functionland/BLOX/Electrical/DevKit/documents/documents_md/Architecture.md

# Functionland DevKit Architecture

## Devkit block diagram
The Devkit block diagram is shown in below figure.

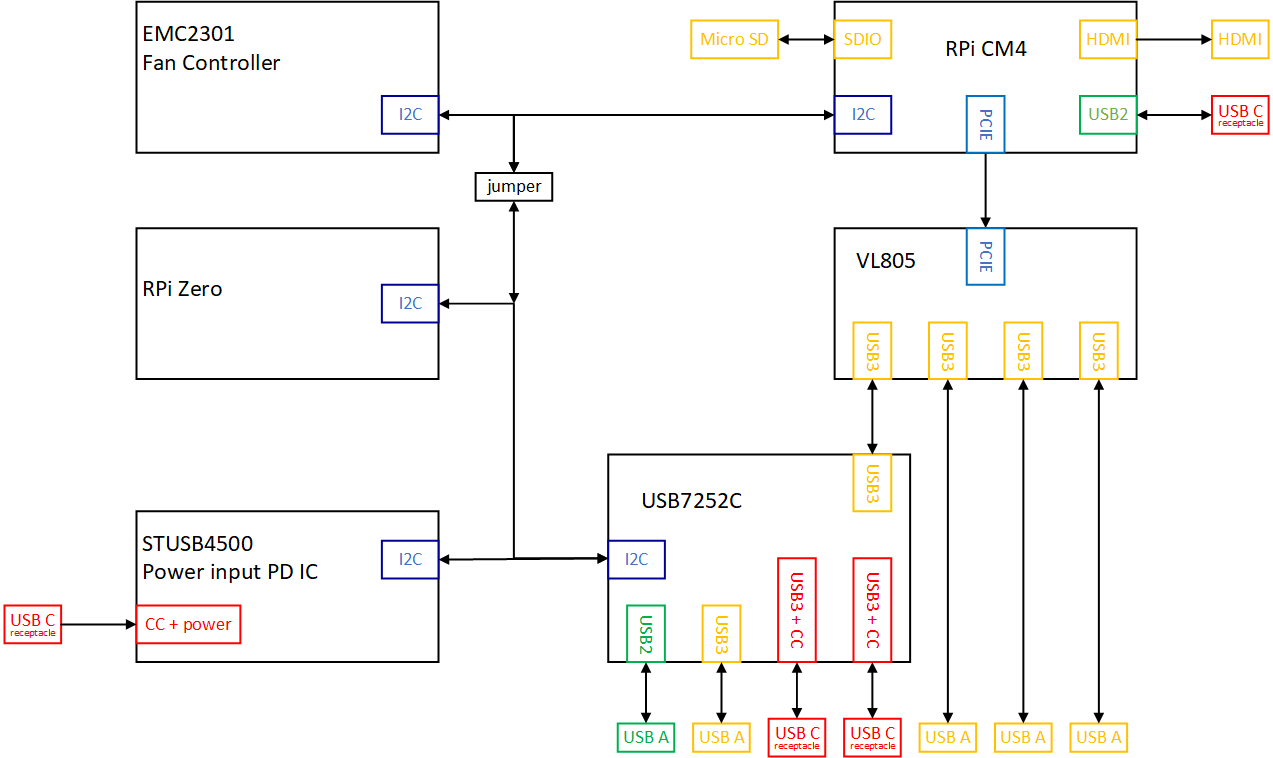
[picture p6: Electrical/DevKit/documents/images/DevKit_block_diagram.png]
DevKit_block_diagram


## Board Features
- RPi CM4 module connector
- RPi Zero module connector
- configuration RPi Zero from USB type-C
- HDMI output port
- Micro SD connector
- Fan connector with PWM controller
- Push button connected to both RPi
- ON-OFF Switch for RPi CM4
- UART TTL connector for both RPi
- Jumpers for enable or disable CM4 features
- 5 USB type A Interfaces
- 2 USB type-C Interfaces
- Power input USB Type-C
- Power input jack
- Power input pin header

&nbsp;

## Board Specifications
### Dimensions
Width: 5.512 in. (14.00 cm)

Length: 5.512 in. (14.00 cm)

Thickness: 0.059 in. (0.15 mm)

**Notes:**

Devkit board documentation (schematics, layout files and board fabrication, 3D model, drawings, etc.) is available on the web at https://github.com/functionland/BLOX/tree/main/Electrical/DevKit/production

&nbsp;

### Environmental
#### Temperature
Operating: 0°C to +45°C

Storage: -25°C to +60°C

#### Humidity
10% to 90% non-condensing

#### Operating Voltage
9-22 VDC
