functionland/BLOX/Electrical/DevKit/documents/Bill of Materials-BAS_DevKITV3(Production).xlsx

ManfactPart | Description | Designator | Comment | LibRef | Quantity | Footprint
 | QR code FxLand 1 | 1 | QR code | ME0023 | 1 | QR_FXLAND_1
CGA2B3X7R1H104K050BB, GCM155R71C104KA55D | 100nF 50V 10% X7R, 100nF 16V 10% X7R | C101, C114, C117, C129, C143, C202, C204, C206, C208, C210, C212, C214, C216, C218, C221, C223, C225, C227, C229, C231, C233, C235, C237, C242, C243, C244, C245, C246, C247, C248, C249, C251, C252, C256, C257, C258, C259, C260, C508, C509, C510, C601, C604, C605, C606, C607, C608, C609, C612, C613, C614, C615, C616, C617, C618, C619, C620, C621, C622, C623, C624, C625, C626, C627, C628, C630, C632, C637 | 100nF | CA0029, CA0010 | 68 | C0402
GRM21BR61C106KE15L, C2012X5R1V106K125AC | 10µF 16V 10% X5R, 10µF 35V 10% X5R | C102, C103, C104, C105, C108, C109, C110, C111, C112, C113, C118, C119, C120, C121, C123, C124, C125, C126, C127, C128, C403, C404 | 10µF | CA0001, CA0005 | 22 | C0805
GRT1555C1H102FA02D | 1nF 50V 1% C0G | C106, C115, C122, C203, C205, C207, C209, C211, C213, C215, C217, C222, C224, C226, C228, C230, C232, C234, C236, C238 | 1nF | CA0031 | 20 | C0402
GCM155R71H122KA37D | 1.2nF 50V 10% X7R | C116 | 1.2nF | CA0030 | 1 | C0402
CC0402GRNPO9BN560 | 56pF 50V 2% C0G | C130 | 56pF | CA0068 | 1 | C0402
GRM155R71H272JA01D | 2.7nF 50V 5% X7R | C131 | 2.7nF | CA0055 | 1 | C0402
C0805C104M5RAC | 100nF 50V 20% X7R | C132, C154, C157 | 100nF | CA0023 | 3 | C0805
GRM188R61C106MAALD | 10µF 16V 20% X5R | C133, C134, C139, C140, C501, C502, C506, C511, C602, C610 | 10µF | CA0008 | 10 | C0603
CGA3E3X5R1V334K080AB | 330nF 35V 10% X5R | C135 | 330nF | CA0004 | 1 | C0603
860010573007 | 100µF 35V 20% 231mA | C136, C155, C156 | 100µF | CA0050 | 3 | RL_6.3_2.5_11
C1608X5R1C475K080AC | 4.7µF 16V 10% X5R | C137, C201, C220 | 4.7µF | CA0002 | 3 | C0603
GCM155R71H392KA37D | 3.9nF 50V 10% X7R | C138 | 3.9nF | CA0066 | 1 | C0402
C1005C0G1H330J050BA | 33pF 50V 5% C0G | C141 | 33pF | CA0067 | 1 | C0402
C0402C681K5RAC | 680pF 50V 10% X7R | C142 | 680pF | CA0065 | 1 | C0402
C1608X5R1C105K080AA | 1µF 16V 10% X5R | C144, C145, C405, C406, C507, C512, C603, C611 | 1µF | CA0003 | 8 | C0603
GRM32ER71J106KA12 | 10µF 63V 10% X7R | C151, C152, C153 | 10µF | CA0024 | 3 | C1210
EMK325ABJ476MM8P | 47µF 16V 20% X5R | C219, C239, C240, C241, C250, C253, C254, C255, C301, C302, C505, C633, C634, C635, C636, C638, C639, C640, C641, C701, C702, C703 | 47µF | CA0007 | 22 | C1210
VJ0402A120FXJCW1BC | 12pF 16V 1% C0G | C261, C262, C629, C631 | 12pF | CA0059 | 4 | C0402
860010675016 | 150µF 50V 20% 363mA | C303, C304 | 150µF | CA0043 | 2 | RL_10_5_12.5
16SVPG330MX | 330µF 16V 20% 16mΩ 4100mA | C401, C402, C503 | 330µF | CA0012 | 3 | EC_E7
16SVPG100M | 100µF 16V 20% 15mΩ 4000mA | C504 | 100µF | CA0011 | 1 | EC_B6
USB4056-03-A | USB C connector Receptacle Horizontal | CO101, CO301, CO302, CO502 | USB4056 | CO0030 | 4 | USB4056-03-A
USB1135-15-9-L-B | USB3.0 Type A receptacle Horizontal | CO303, CO701, CO702, CO703 | USB1135 | CO0041 | 4 | USB1135-15-9-L-B
USB1130-15-A | USB2.0 Type A receptacle Horizontal | CO304 | USB1130 | CO0040 | 1 | USB1130-15-A
693071030811 | µSD-Card holder | CO501 | µSD-Card | CO0027 | 1 | 693071030811
10029449 | HDMI | CO503 | HDMI | CO0007 | 1 | HDMI
ESDA25W | TRANSIL array for data protection | D102 | TVS | DI0009 | 1 | SOT-323
KP-2012CGCK | Led Green | D103, D104, D105, D106, D107, D108, D501, D502, D504, D505 | Led Green | DI0001 | 10 | Led0805
BAS16_R1_00001 | Diodes - General Purpose, Power, Switching 100Vll Signal Switching Diodes 2A | D201, D601 | BAS16 | DI0010 | 2 | SOT-23
TPD2EUSB30DRTR | USB 2 TVS Diode | D301, D302, D303, D304, D503, D702, D704, D706 | TVS | DI0002 | 8 | SOT-3
PUSB3FA2Z | USB 3 TVS Diode | D305, D306, D307, D308, D309, D701, D703, D705 | TVS | DI0007 | 8 | SOT-1176-1
 | Fiducial Round 1mm | Fid1, Fid3, Fid6, Fid8 | Fiducial | ME0011 | 4 | FidR_1.0mm
 | Fiducial Sqaure 1mm | Fid2, Fid4, Fid5, Fid7 | Fiducial | ME0012 | 4 | FidS_1.0mm
 | Mounting Hole M4 | H1, H2, H3, H4 | Hole M4 | ME0002 | 4 | HOLE_M4
AP64501SP-13 | 3.8V TO 40V INPUT, 5A LOW IQ SYNCHRONOUS BUCK WITH PROGRAMMABLE SOFT-START TIME | IC101, IC102 | AP64501SP-13 | IC0031 | 2 | SO-8-EP
HL7504FN04, HL7504FN08 | 3MHz 2A Buck Converter 1.05V OUT, 3MHz 2A Buck Converter 1.10V OUT | IC103, IC105 | HL7504 | IC0049, IC0050 | 2 | DFN-6G_2X2
MCP19035-BAABE/MF | Switching Controllers Synchronous Buck PWM Control 600kHz 12ns | IC104 | MCP19035 | IC0055 | 1 | DFN-10G_3X3
STUSB4500QTR | USB Interface IC Standalone USB PD controller for power sinking devices | IC106 | STUSB4500 | IC0057 | 1 | QFN-24G_4X4
UCS2114 | Dual USB Power Switch with Integrated Current Sensor | IC201, IC205, IC603, IC604 | UCS2114 | IC0056 | 4 | VQFN-20_3X3
SST26VF016B-104V/SN | 16 Mbit Serial Quad I/O (SQI) Flash Memory | IC202 | SST26VF016B | IC0059 | 1 | SO-8
USB7252C | 4-Port USB 3.2 Gen 2 Type-C Controller Hub | IC203 | USB7252C | IC0047 | 1 | VQFN-100G_12X12
MC74HC1G02DTT1G | Logic Gates 2-6V Single 2-Input NOR | IC204 | MC74HC1G02 | IC0061 | 1 | TSOP-5
RT9742GGJ5 | RT9742 High side power switch | IC501 | RT9742 | IC0029 | 1 | SOT-23-5
EMC2301-1-ACZL-TR | Board Mount Temperature Sensors Single RPB-Based PWM Fan Speed CNTRL | IC502 | EMC2301 | IC0054 | 1 | MSOP-8_3X3
RT9742SNGV | RT9742SNGV | IC503 | RT9742 | IC0011 | 1 | SOT-23
SN74LVC1G07DBVT | Buffer IC | IC504 | SN74LVC1G07D | IC0009 | 1 | SOT-23-5
AT25SF321B-SSHB-T | 32-Mbit SPI Serial Flash Memory with Dual-I/O and Quad-I/O Support | IC601 | AT25SF321B | IC0053 | 1 | SO-8
VL805-Q6 | VL805 4-Port USB 3.0 Host Controller | IC602 | VL805 | IC0046 | 1 | QFN-68G_8X8
G800MJ302018EU | Header 1x6P SMT Mount | J103, J201 | Header | CO0043 | 2 | 1X6P_2.54MM_SMT
 | SPI Programming connection | J202, J601 | SPI | ME0028 | 2 | SPI_PROG_TYPE1
G800W305018EU | Header 1x3P | J401, J402, J505 | Header | CO0018 | 3 | 1X3P_2.54mm
470531000 | Fan Connector 4pin | J502 | Fan Connector | CO0010 | 1 | 470531000
G800W306018EU | Header 1x2P | J504, J507, J508, J509 | Header | CO0012 | 4 | 1X2P_2.54mm
SRN6045TA-3R3Y | 3.3µH 5A 30% 21mΩ | L101, L102 | 3.3µH 5A | IN0005 | 2 | SRN6045TA
NRS4018T2R2MDGJ | 2.2µH 3A | L103, L105 | 2.2µH 3A | IN0004 | 2 | NRS4018
0630CDMCDDS-1R0MC | 1.5µH 14.4A 20% 7.4mΩ | L104 | 1.5µH 14.4A | IN0017 | 1 | 0630CDMCDDS
 | Logo FxLand 3 | Logo FxLand1 | FxLand | ME0008 | 1 | Logo_FxLand_3
9900002236265 | RPI ZeroW Header 1-40 | MO401 | ZeroW-1 | MO0017 | 1 | RPIZeroW_HeaderPins
9774030151R | RPI ZeroW Mounting Studs | MO402, MO403, MO404, MO405 | ZeroW-M | MO0016 | 4 | CM4-M
RPI Zero W | Outline of ZeroW Heigthened P\lacement | MO406 | ZeroW | MO0022 | 1 | RPIZeroW_Layout_Heightened
DF40HC(3.0)-100DS-0.4V | RPI CM4 Pin 1-100 | MO501 | CM4-1 | MO0012 | 1 | CM4_001-100
DF40HC(3.0)-100DS-0.4V | RPI CM4 Pin 101-200 | MO502 | CM4-2 | MO0013 | 1 | CM4_101-200
9774030151R | RPI CM4 Mounting Studs | MO503, MO504, MO505, MO506 | CM4-M | MO0014 | 4 | CM4-M
RPI CM4 | Outline of CM4 | MO507 | CM4 | MO0011 | 1 | RPICM4_Layout
WR06X1000FTL | 100Ω 1% 100mW | R101, R106, R119 | 100Ω | RS0007 | 3 | R0603
RC0402FR-1312KL | 12KΩ 1% 62.5mW | R102, R216, R501 | 12KΩ | RS0015 | 3 | R0402
ERJ-S02F2002X | 20KΩ 1% 100mW 100PPM | R103, R115 | 20KΩ | RS0034 | 2 | R0402
CRGCQ0402F2K2, MCMR04X222 JTL | 2.2KΩ 1% 62.5mW 100PPM, 2.2KΩ 5% 62.5mW | R104, R505, R506, R511, R512 | 2.2KΩ | RS0035, RS0020 | 5 | R0402
CRCW060369K8FKEB | 69.8KΩ 1% 100mW 100PPM | R107 | 69.8KΩ | RS0041 | 1 | R0603
CRCW040210K5FKEDC | 10.5KΩ 1% 62.5mW 100PPM | R108 | 10.5K | RS0054 | 1 | R0402
RC0603FR-0722K1L | 22.1KΩ 1% 100mW 100PPM | R109, R218 | 22.1KΩ | RS0040 | 2 | R0603
0402WGF1004TCE | 1MΩ 1% 62.5mW 100PPM | R110, R113 | 1MΩ | RS0066 | 2 | R0402
AC0402FR-13100KL | 100KΩ 1% 62.5mW 100PPM | R111, R112, R118, R126, R127, R202, R205, R247, R406, R619 | 100KΩ | RS0036 | 10 | R0402
0402WGF8201TCE | 8.2KΩ 1% 62.5mW 100PPM | R114 | 8.2KΩ | RS0079 | 1 | R0402
CRG0402F750R | 750Ω 1% 62.5mW 100PPM | R116 | 750Ω | RS0078 | 1 | R0402
CRG0402F2K7 | 2.7KΩ 1% 62.5mW 100PPM | R117 | 2.7KΩ | RS0059 | 1 | R0402
MCWR04X2202FTL | 22KΩ 1% 62.5mW 100PPM | R120 | 22KΩ | RS0033 | 1 | R0402
WR06X102 JTL | 1KΩ 5% 100mW | R121, R122, R130 | 1KΩ | RS0008 | 3 | R0603
RC0402JR-131KL | 1KΩ 5% 62.5mW 100PPM | R123, R124 | 1KΩ | RS0037 | 2 | R0402
WR04X1002FTL | 10KΩ 1% 62.5mW | R125, R203, R204, R212, R213, R214, R215, R228, R229, R231, R234, R235, R236, R243, R401, R405, R508, R601, R602, R607, R608, R609, R611, R612, R613, R614, R623, R624 | 10KΩ | RS0011 | 28 | R0402
MCWR06X1500FTL | 150Ω 1% 100mW | R129, R132, R504, R510, R515, R516 | 150Ω | RS0001 | 6 | R0603
RT0603BRE0750RL | 50Ω 0.1% 100mW 50PPM | R131 | 50Ω | RS0080 | 1 | R0603
CRCW040243K0FKEDC | 43KΩ 1% 62.5mW 100PPM | R201, R237 | 43KΩ | RS0076 | 2 | R0402
CRG0402F200K | 200KΩ 1% 62.5mW 100PPM | R206, R209, R210, R219, R220, R221, R222, R223, R224, R225, R226, R230 | 200KΩ | RS0045 | 12 | R0402
0402WGF4992TCE | 49.9KΩ 1% 62.5mW 100PPM | R211, R241 | 49.9KΩ | RS0077 | 2 | R0402
CRCW04025K10FKEDC | 5.1KΩ 1% 62.5mW 100PPM | R217, R502, R509 | 5.1kΩ | RS0038 | 3 | R0402
0402WGF3302TCE | 33KΩ 1% 62.5mW 100PPM | R227, R244 | 33KΩ | RS0075 | 2 | R0402
0402WGJ0000TCE | 0Ω 62.5mW | R232, R233, R239, R242, R248, R249, R250, R251, R519, R615, R616, R621, R625, R626 | 0Ω | RS0074 | 14 | R0402
WR06X4701FTL | 4.7KΩ 1% 100mW | R402, R403, R404 | 4.7KΩ | RS0002 | 3 | R0603
ERJ-2RKF3602X | 36KΩ 1% 62.5mW 100PPM | R513 | 36KΩ | RS0051 | 1 | R0402
WR06X103 JTL | 10KΩ 5% 100mW | R514 | 10KΩ | RS0003 | 1 | R0603
0201WMJ0330TEE | 33Ω 5% 50mW 200PPM | R603, R604 | 33Ω | RS0067 | 2 | R0201
0201WMF499JTEE | 49.9Ω 1% 50mW 200PPM | R605, R606 | 49.9Ω | RS0069 | 2 | R0201
RC0402FR-076K04L | 6.04KΩ 1% 62.5mW | R610 | 6.04KΩ | RS0017 | 1 | R0402
TS02-66-50-BK-160-SCR-D | TACTILE SWITCH SPST | SW201 | TS02 | SW0005 | 1 | TS02
PTS645VK832LFS | TACTILE SWITCH SPST | SW401, SW503 | PTS645 | SW0003 | 2 | PTS645-V
OS102011MS2QN1 | Miniature Slide Switch SPDT | SW504 | OS102011 | SW0001 | 1 | OS10_Series
 | Testpoint 1mm | TP_+1V1, TP_+1V05, TP_+3V3, TP_+5VR, TP_+5VU, TP_CPWR, TP_GND, TP_VIN, TP_VPWR | TP | ME0027 | 9 | TP_1MM
SIRA24DP-T1-GE3 | 25V/2.4mΩ, N-channel Power MOSFET, 35.6A | TR102 | SiRA24DP | TR0012 | 1 | PowerPAK-SO-8_5X6
SIRA12BDP-T1-GE3 | 30V/6mΩ, N-channel Power MOSFET, 22A | TR103 | SiRA12BDP | TR0013 | 1 | PowerPAK-SO-8_5X6
STL8P4LLF6 | 40V/17.5mΩ, P-channel Trench MOSFET, 8A | TR104 | STL8P4LLF6 | TR0010 | 1 | PowerFLAT-3.3x3.3-8
403WF25012IK | 25MHz 8pF 20PPM | X201, X601 | 25MHz | CR0003 | 2 | 403W
