functionland/BLOX/Electrical/DevKit/documents/schematic.PDF

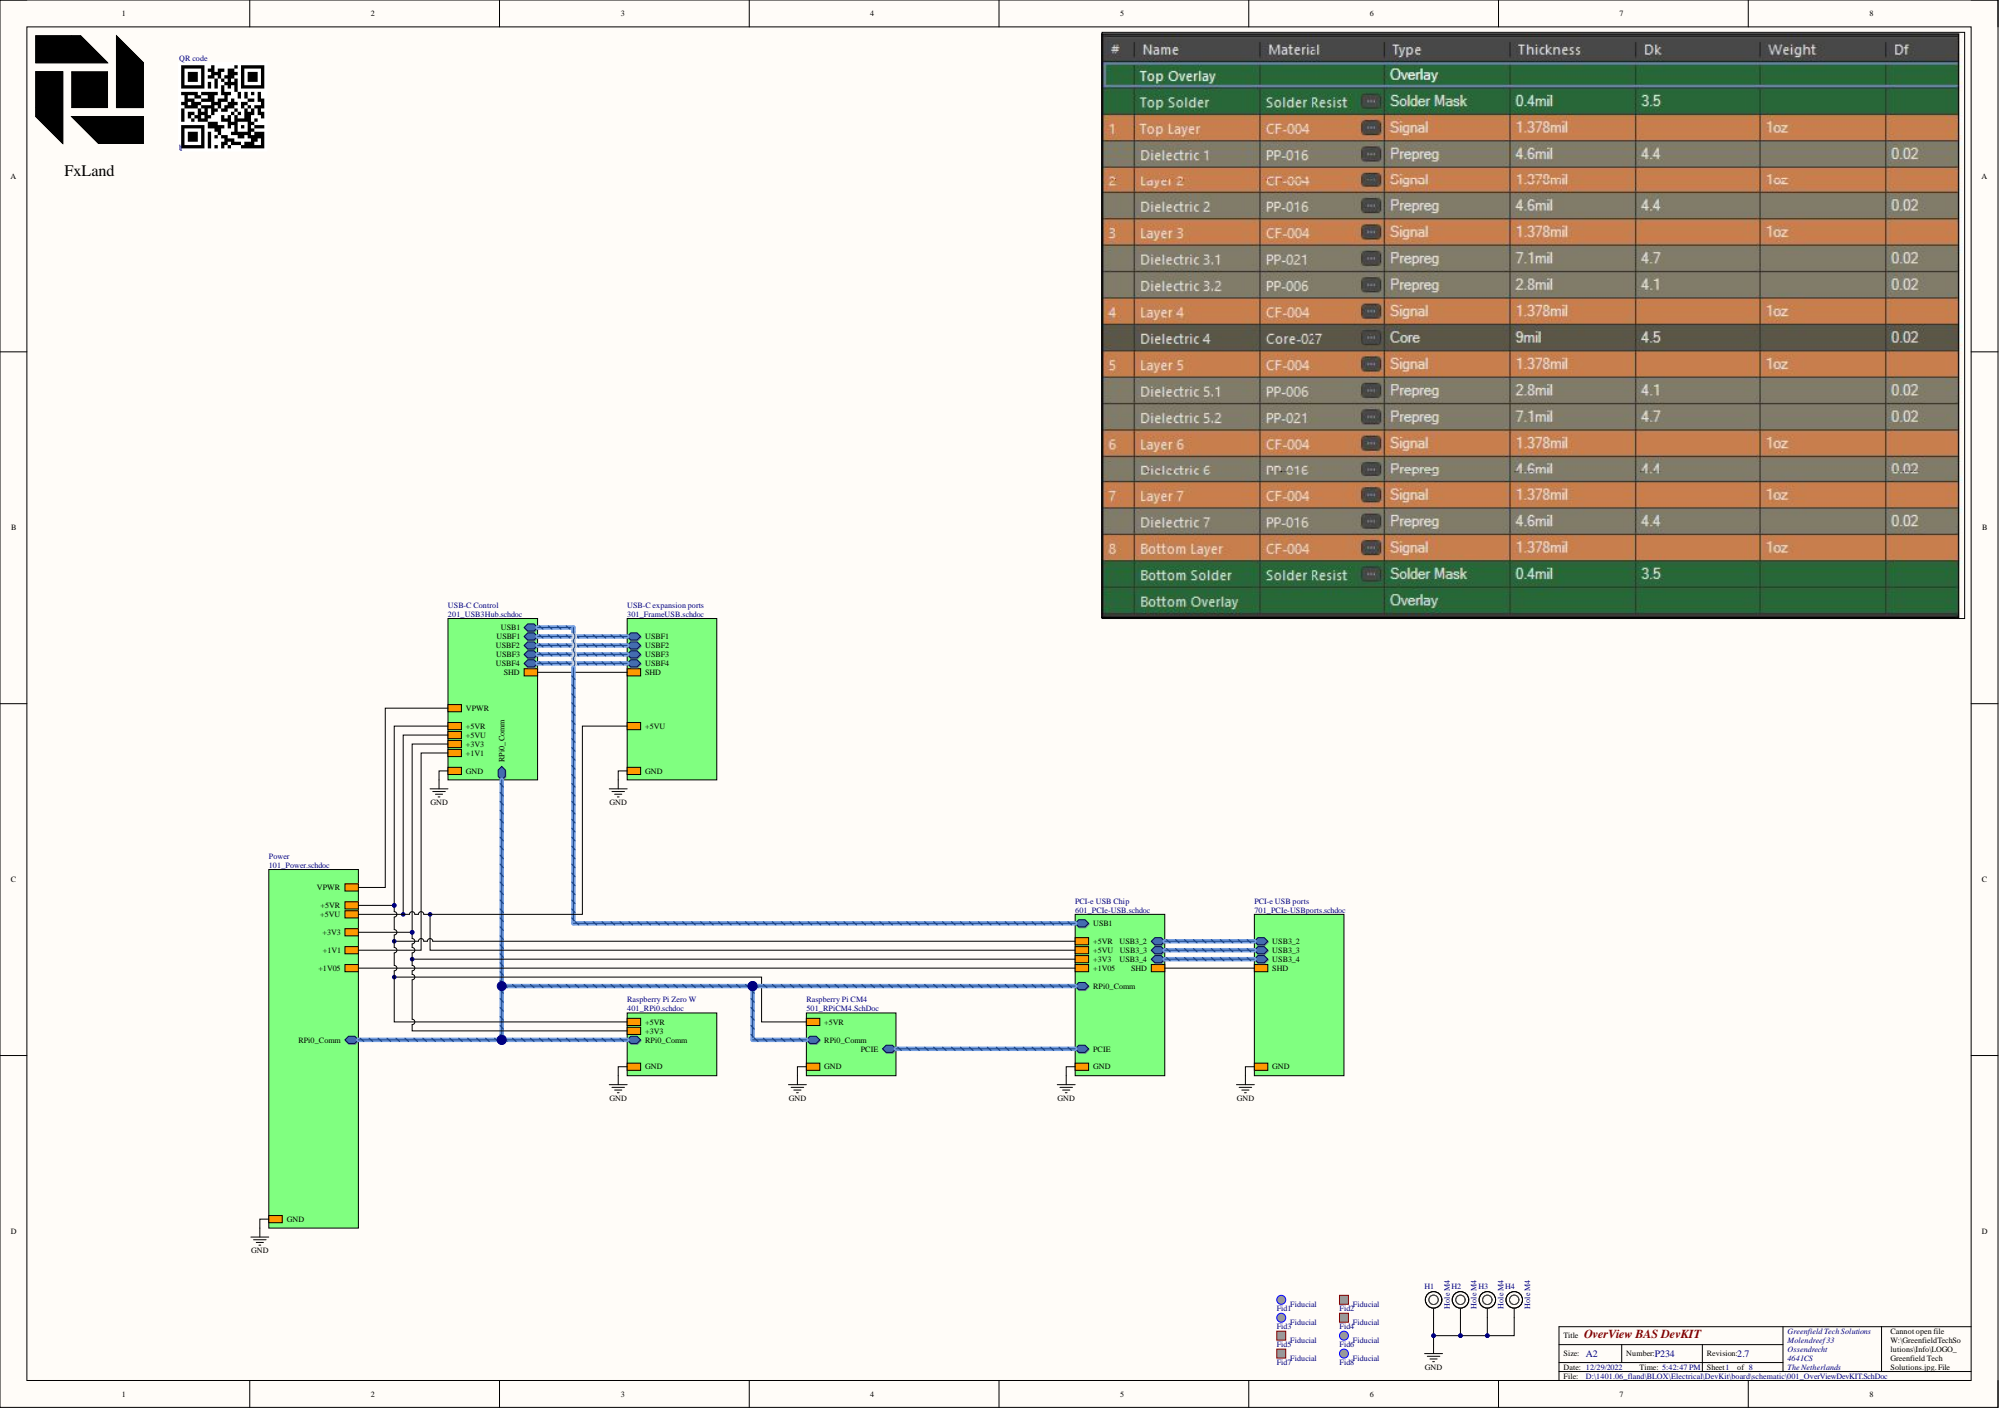
[picture p11: page 1]

D:\1401.06_fland\BLOX\Electrical\DevKit\board\schematic\001_OverViewDevKIT.SchDoc

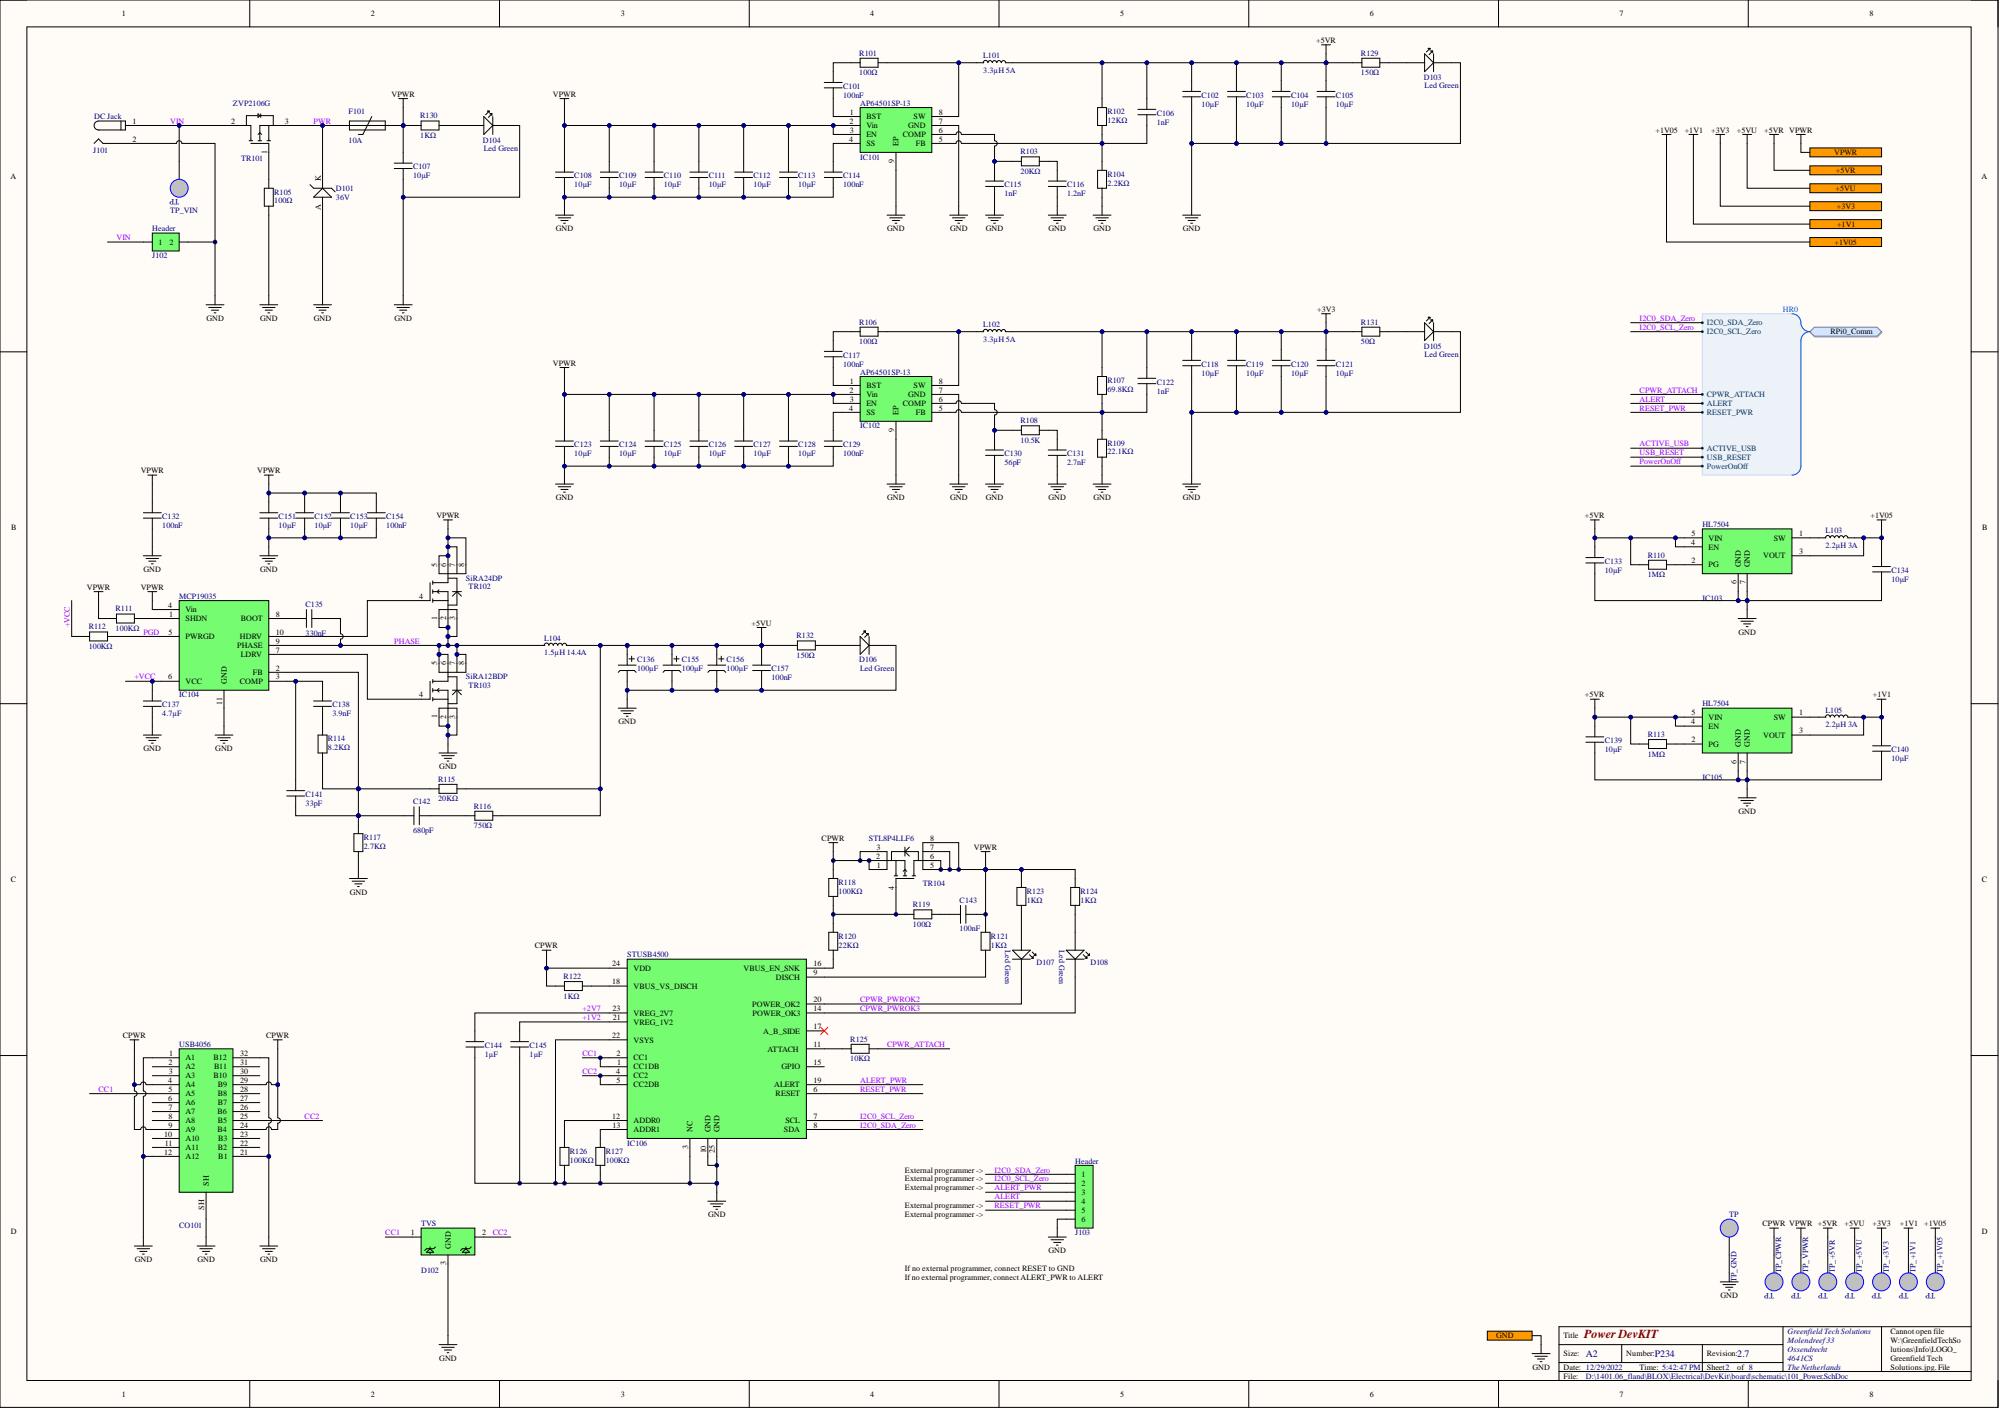
[picture p12: page 2]

PWRGD 5 | 330nF
VCC 6 | | PHASE

If no external programmer, connect RESET to GND
If no external programmer, connect ALERT_PWR to ALERT

D:\1401.06_fland\BLOX\Electrical\DevKit\board\schematic\101_Power.SchDoc

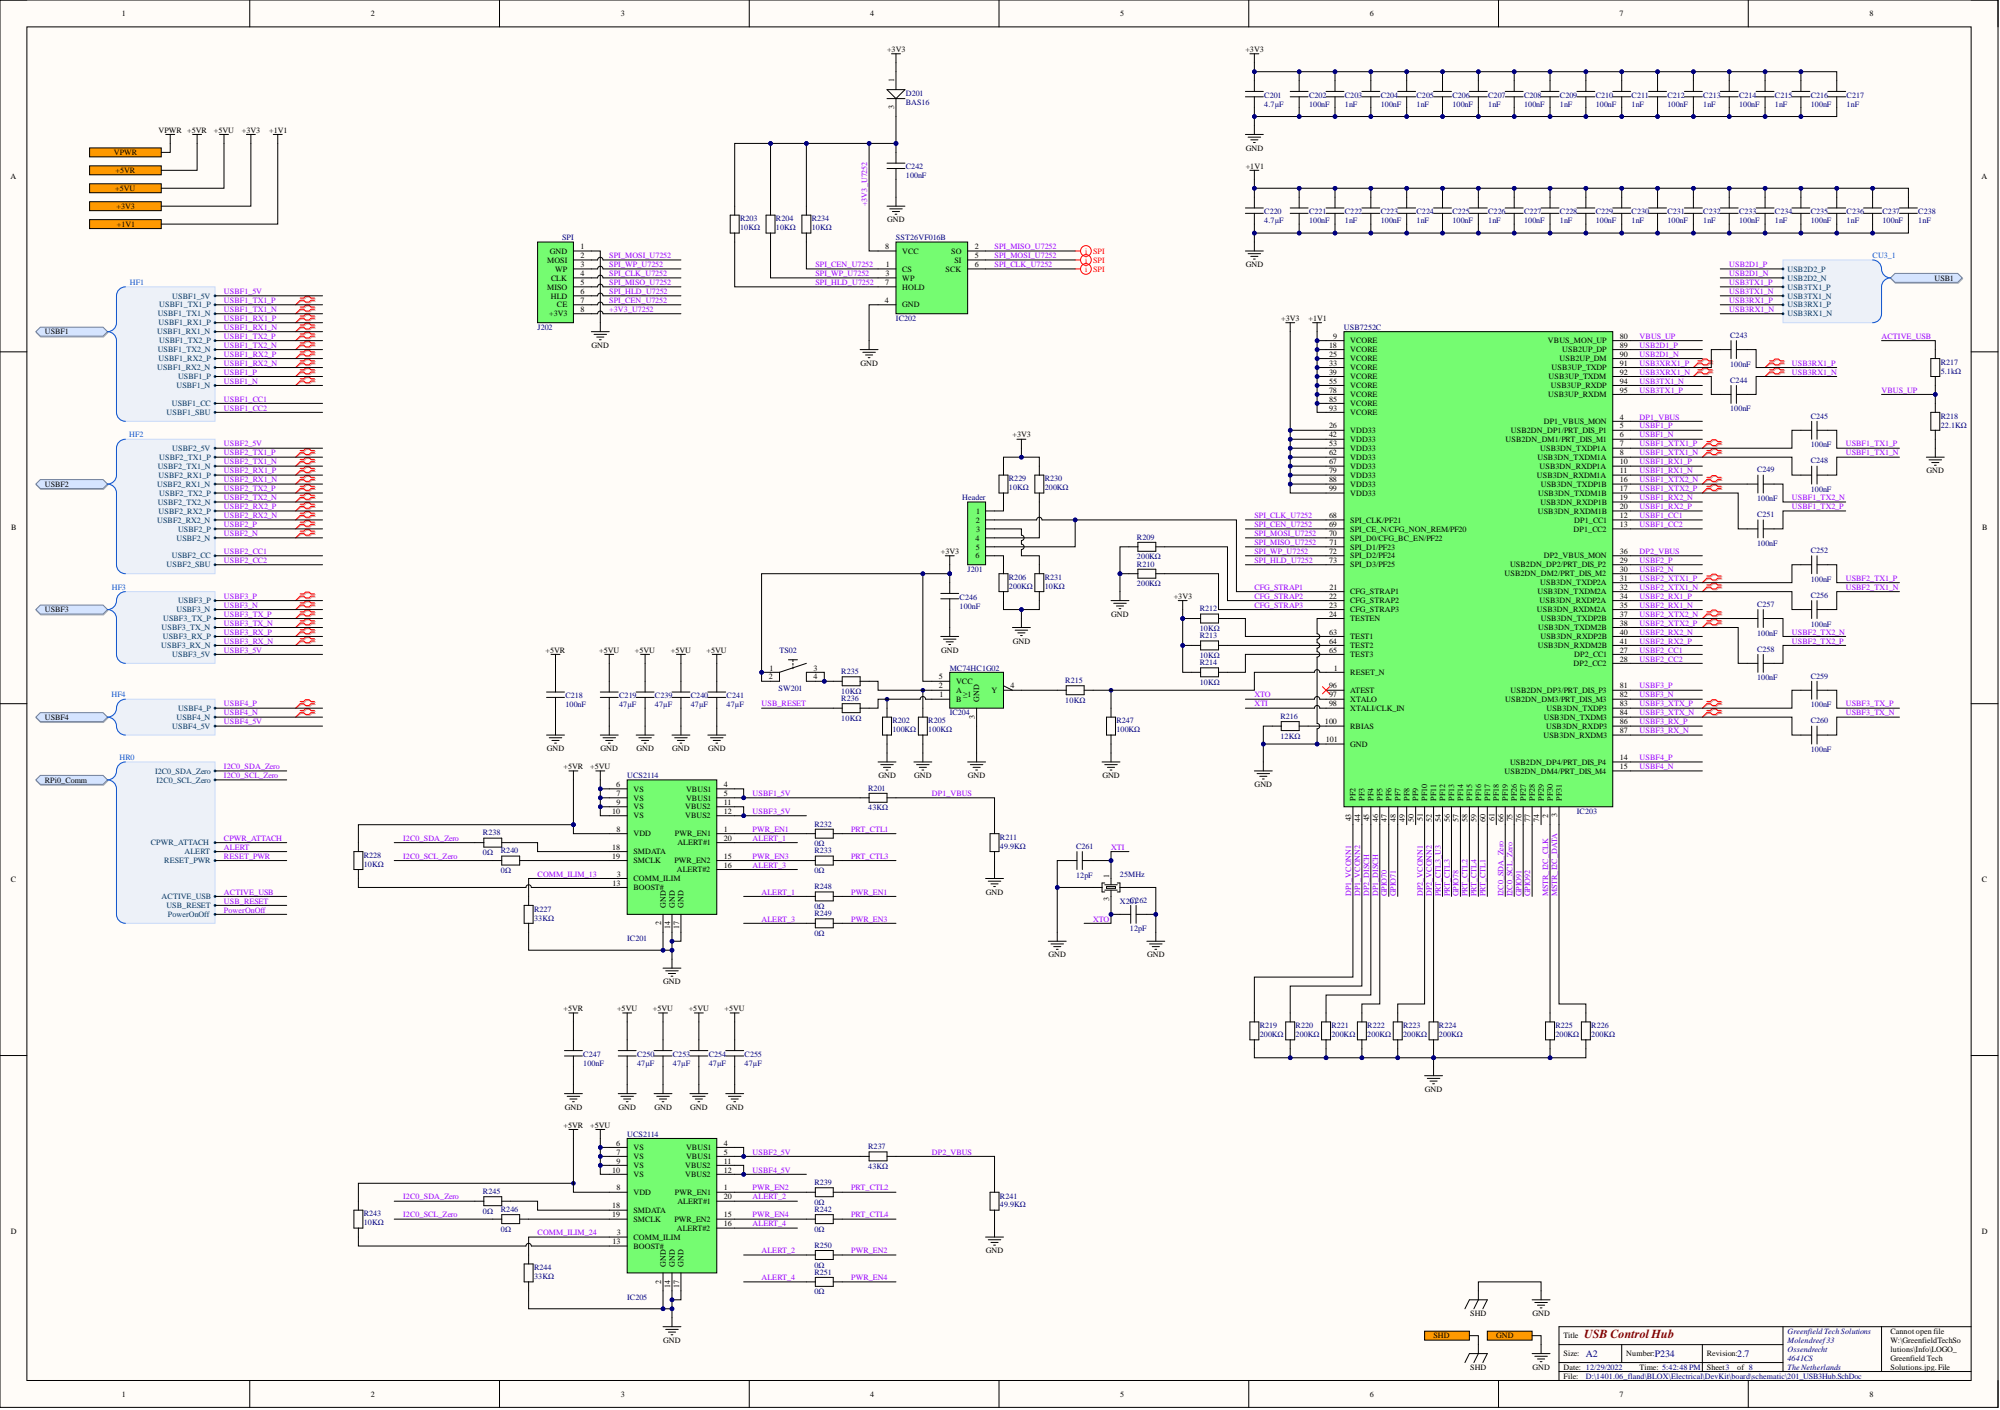
[picture p13: page 3]

VCORE 18 | USB2D1_P
VCORE 25 | | USB2D1_N | USB3RX1_P
VCORE 33 | | USB3XRX1_P
VCORE 39 | USB3XRX1_N USB3RX1_N
VCORE 55 | | USB3TX1_N

VDD33 42 | | USBF1_N | | USBF1_TX1_P
VDD33 53 | | USBF1_XTX1_P
VDD33 62 | USBF1_XTX1_N USBF1_TX1_N
VDD33 67 | | USBF1_RX1_P C249
VDD33 79 | | USBF1_RX1_N
VDD33 88 | USBF1_XTX2_N
VDD33 99 | USBF1_XTX2_P | | 100nF USBF1_TX2_N
SPI_CLK/PF21 68 | USBF1_RX2_N

CFG_STRAP3 | | CFG_STRAP3 23 | | USBF2_RX1_N

TESTEN 24 | USBF2_XTX2_N
TEST1 63 | USBF2_XTX2_P | 100nF USBF2_TX2_N

USBF2_RX2_N

TEST2 64 | | USBF2_RX2_P
TEST3 65 | | USBF2_CC1
RESET_N 1 | | USBF2_CC2

USBF3_RX_P

12KΩ | | GND 101 | USBF3_RX_N

VS 7
VS 9

D:\1401.06_fland\BLOX\Electrical\DevKit\board\schematic\201_USB3Hub.SchDoc

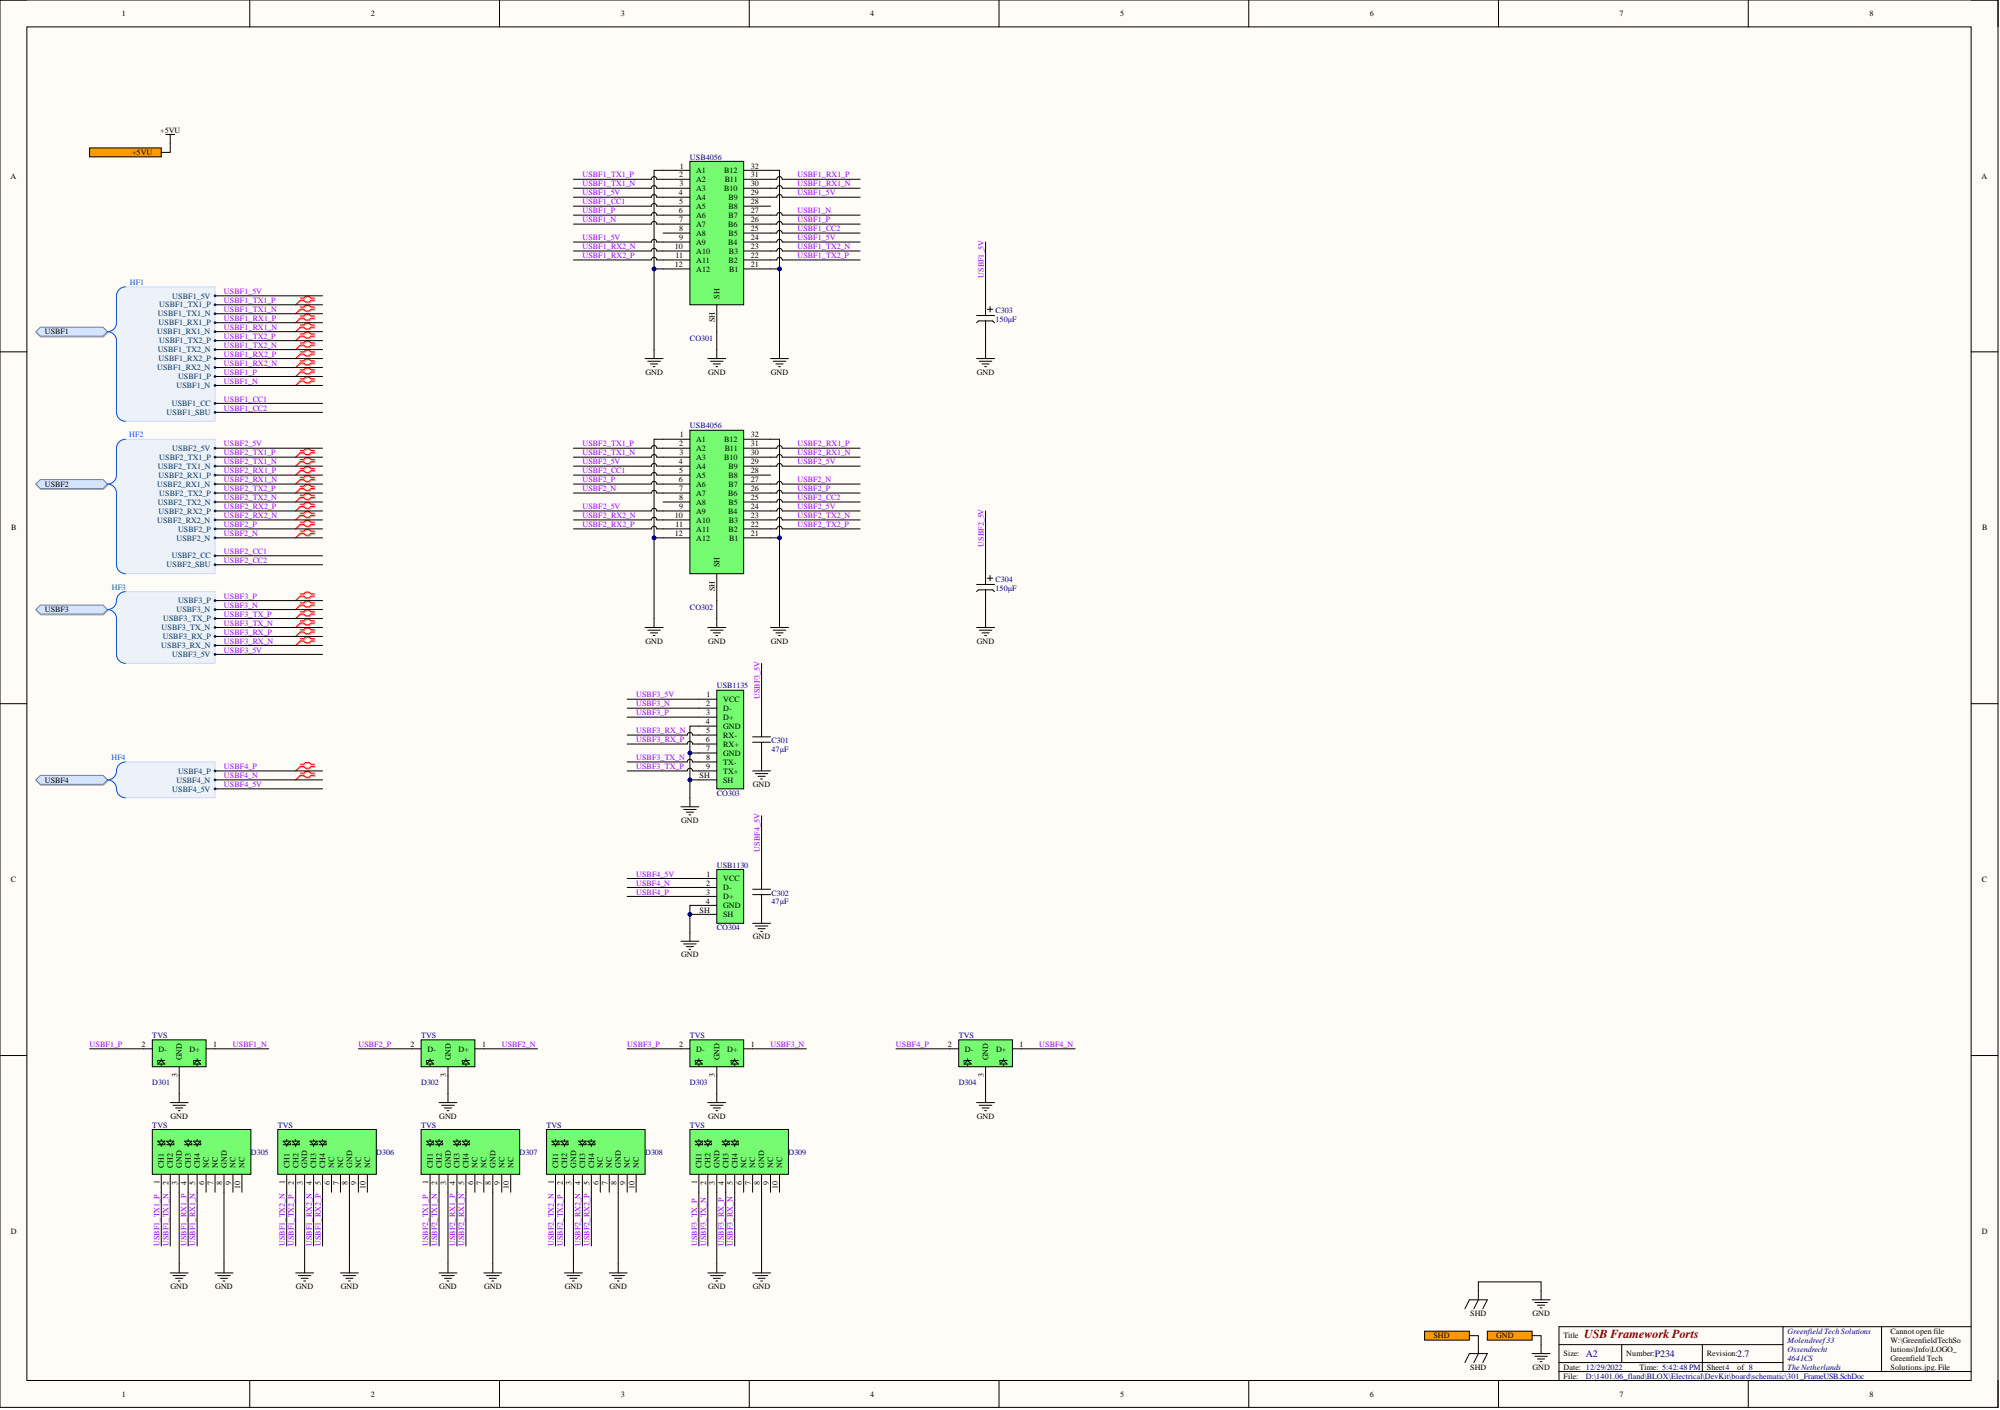
[picture p14: page 4]

A6 6
A7 7
A8 8

A10 10
A11 11

GND 4
RX- 5
RX+ 6
GND 7
TX- 8
TX+ 9
SH SH

D:\1401.06_fland\BLOX\Electrical\DevKit\board\schematic\301_FrameUSB.SchDoc

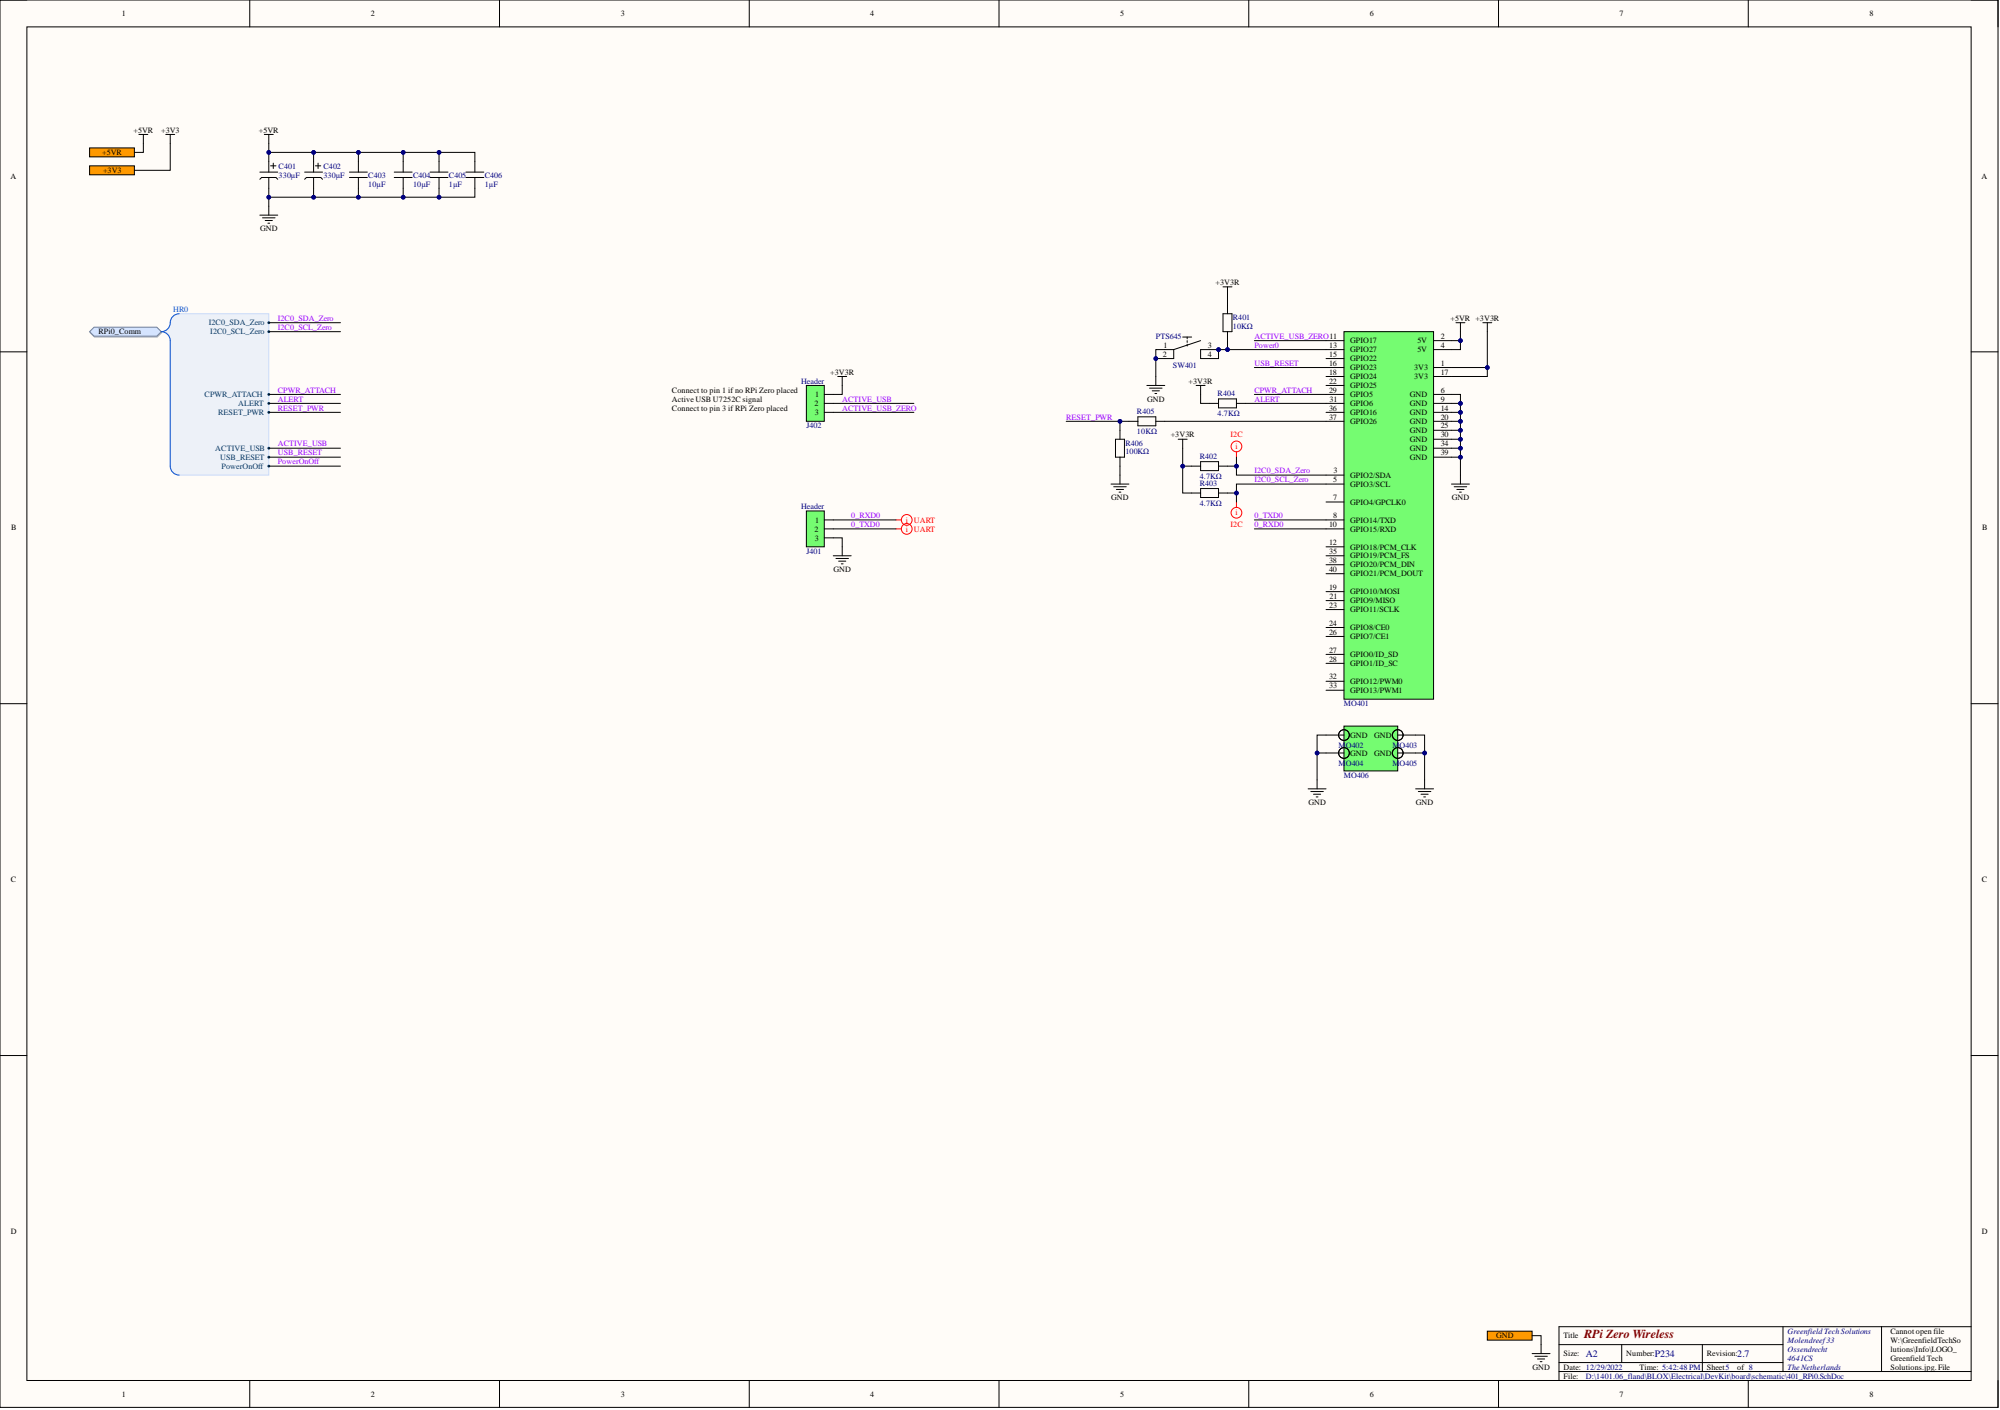
[picture p15: page 5]

Connect to pin 1 if no RPi Zero placed
Active USB U7252C signal

D:\1401.06_fland\BLOX\Electrical\DevKit\board\schematic\401_RPi0.SchDoc

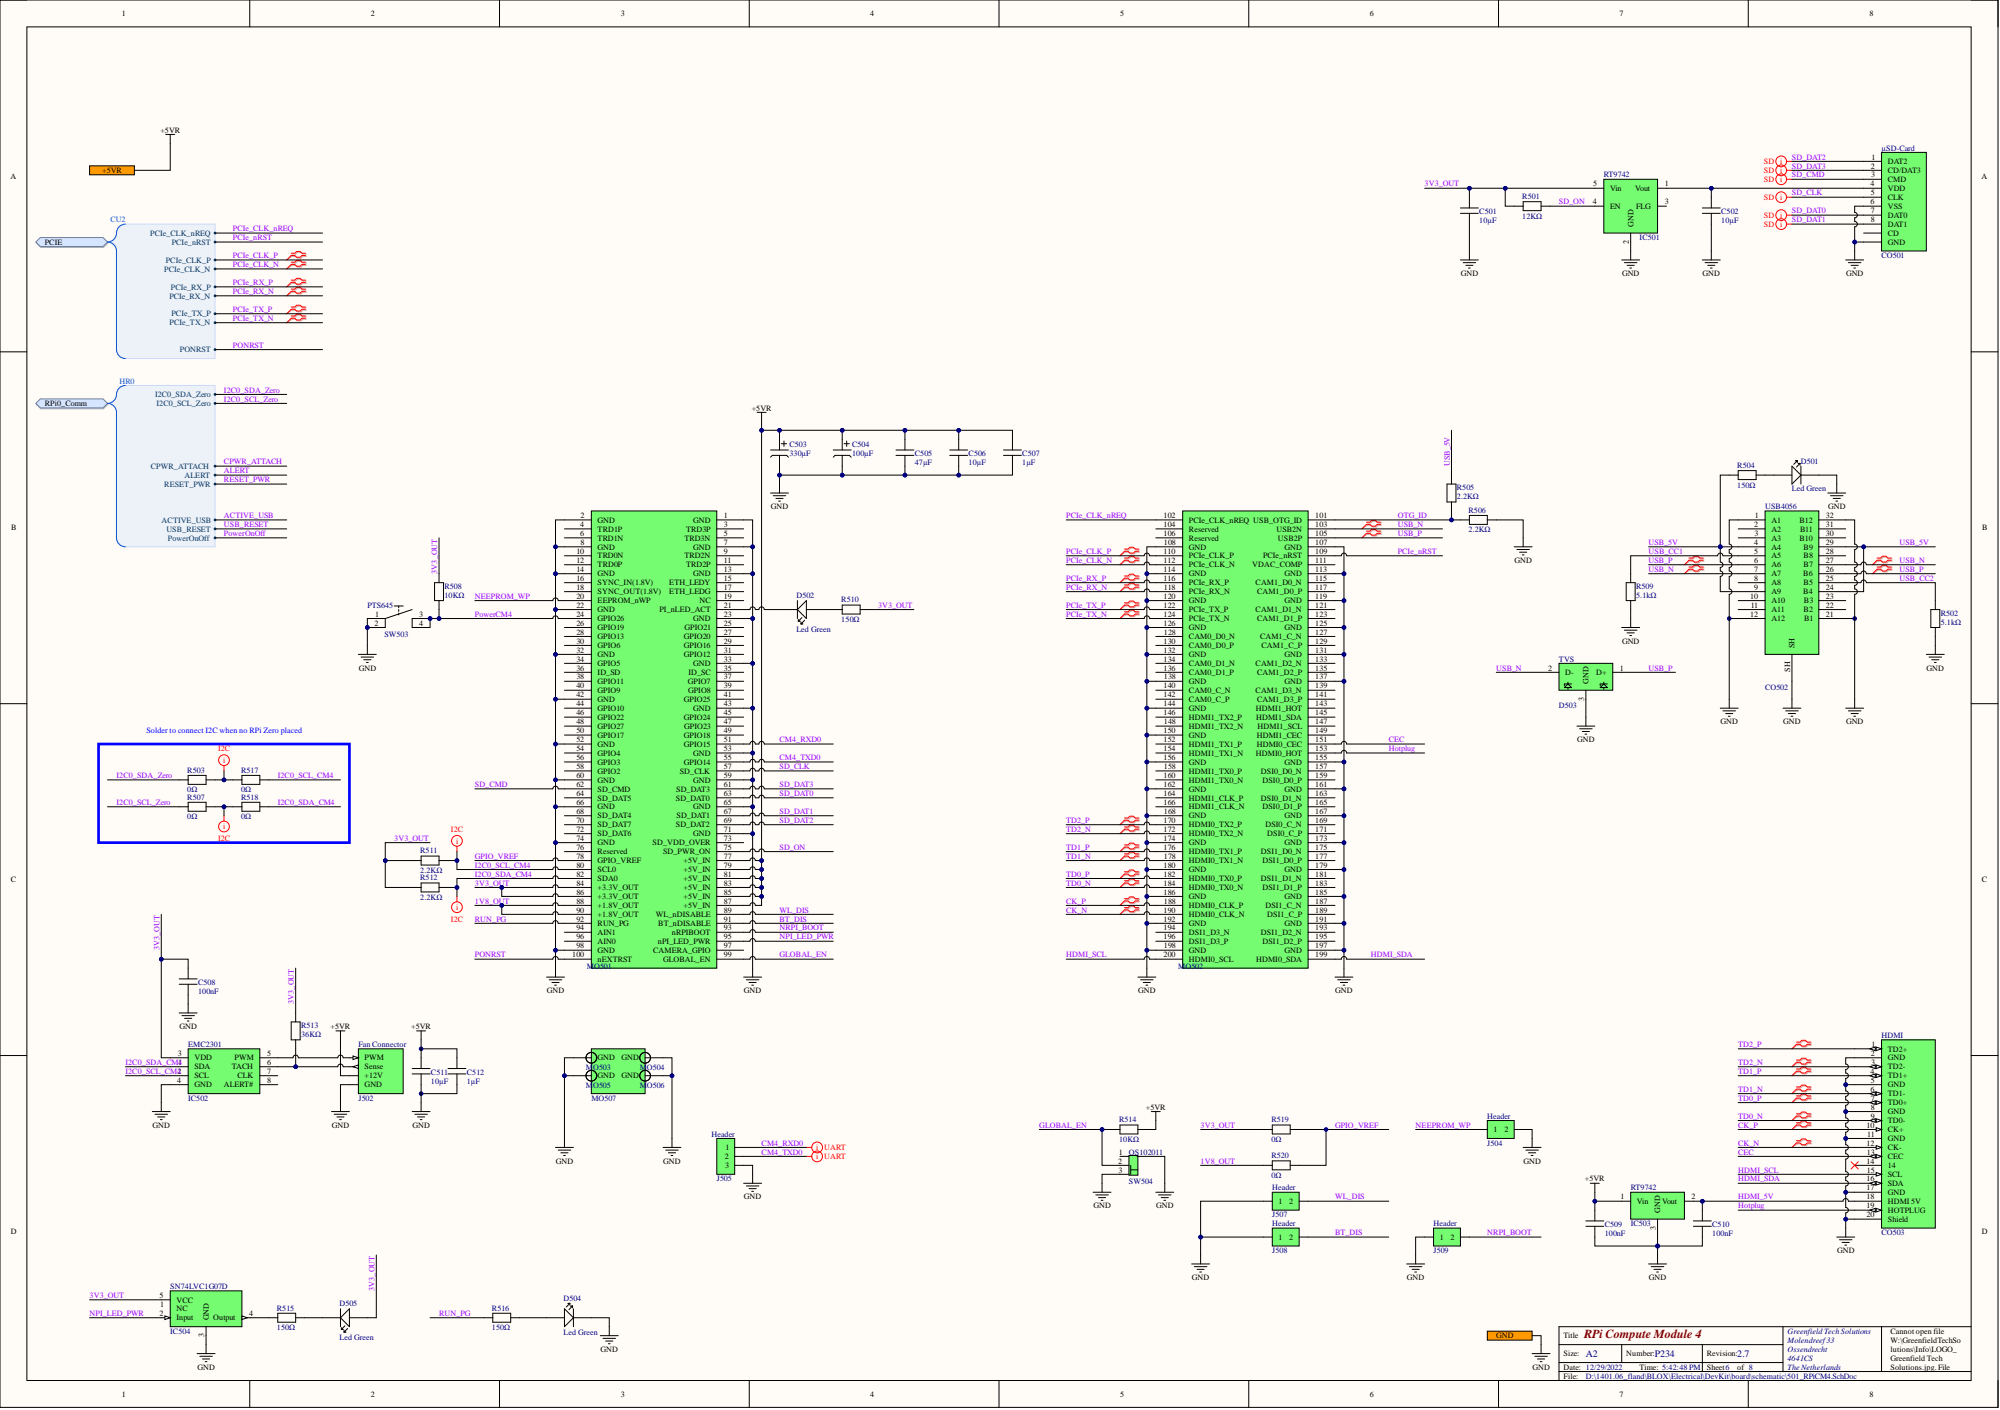
[picture p16: page 6]

R501 | SD_CLK | CLK 5

VSS 6
DAT0 7

USB_P USB_N | A6 6 A7 7

Solder to connect I2C when no RPi Zero placed

GND 17

Hotplug | | HOTPLUG 19

Shield 20

D:\1401.06_fland\BLOX\Electrical\DevKit\board\schematic\501_RPiCM4.SchDoc

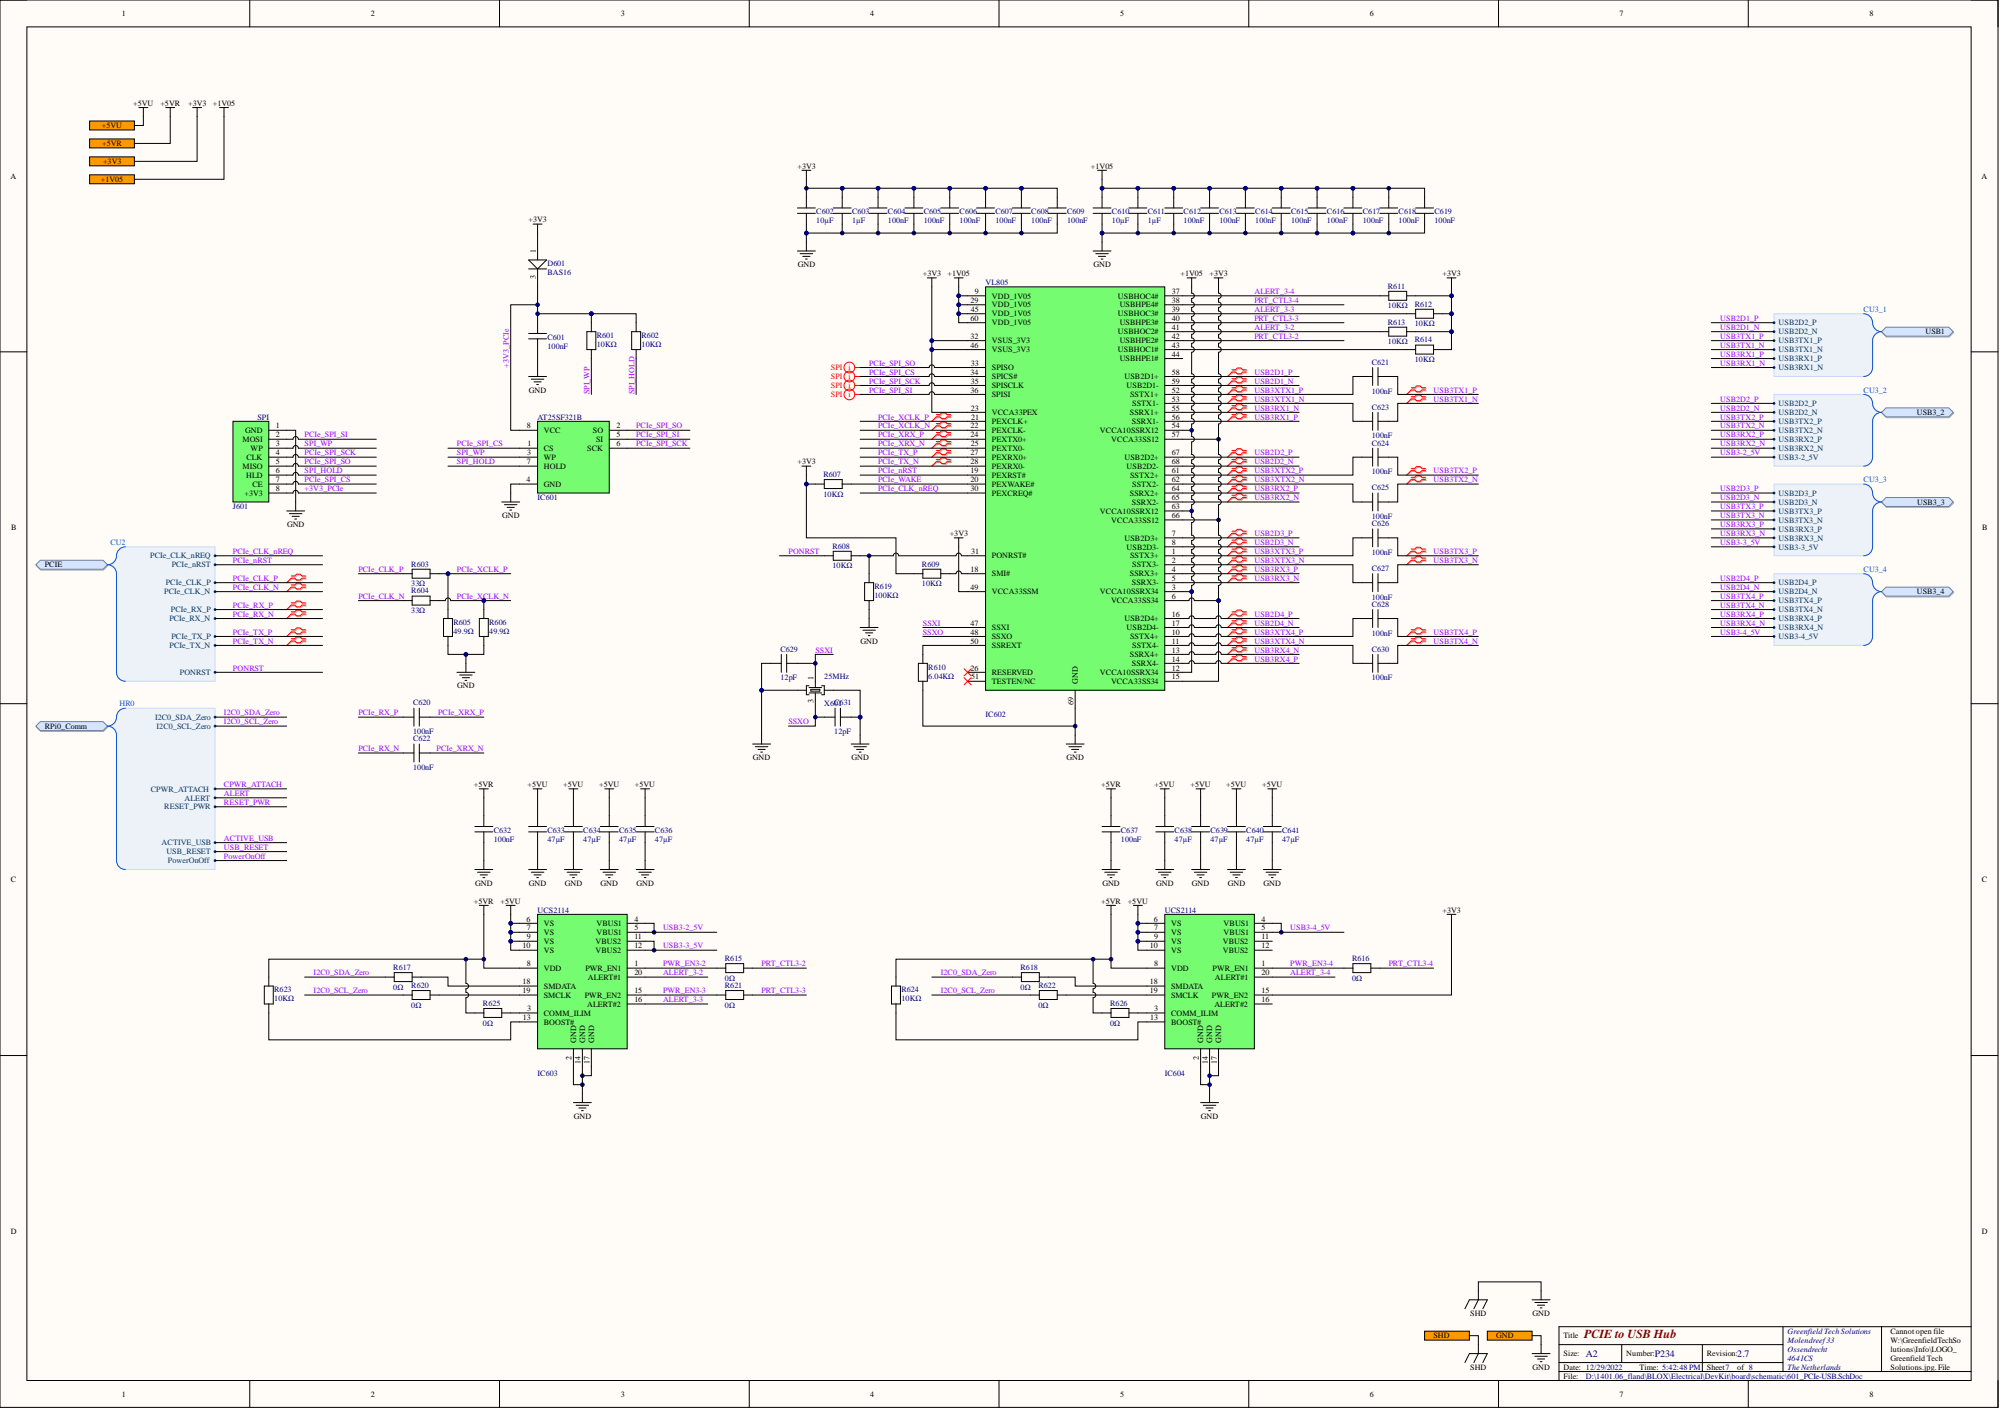
[picture p17: page 7]

VSUS_3V3 46

SPICS# 34

SPISI 36

R609 | SMI# 18

VCCA33SSM 49

PCIE to USB Hub

D:\1401.06_fland\BLOX\Electrical\DevKit\board\schematic\601_PCIe-USB.SchDoc

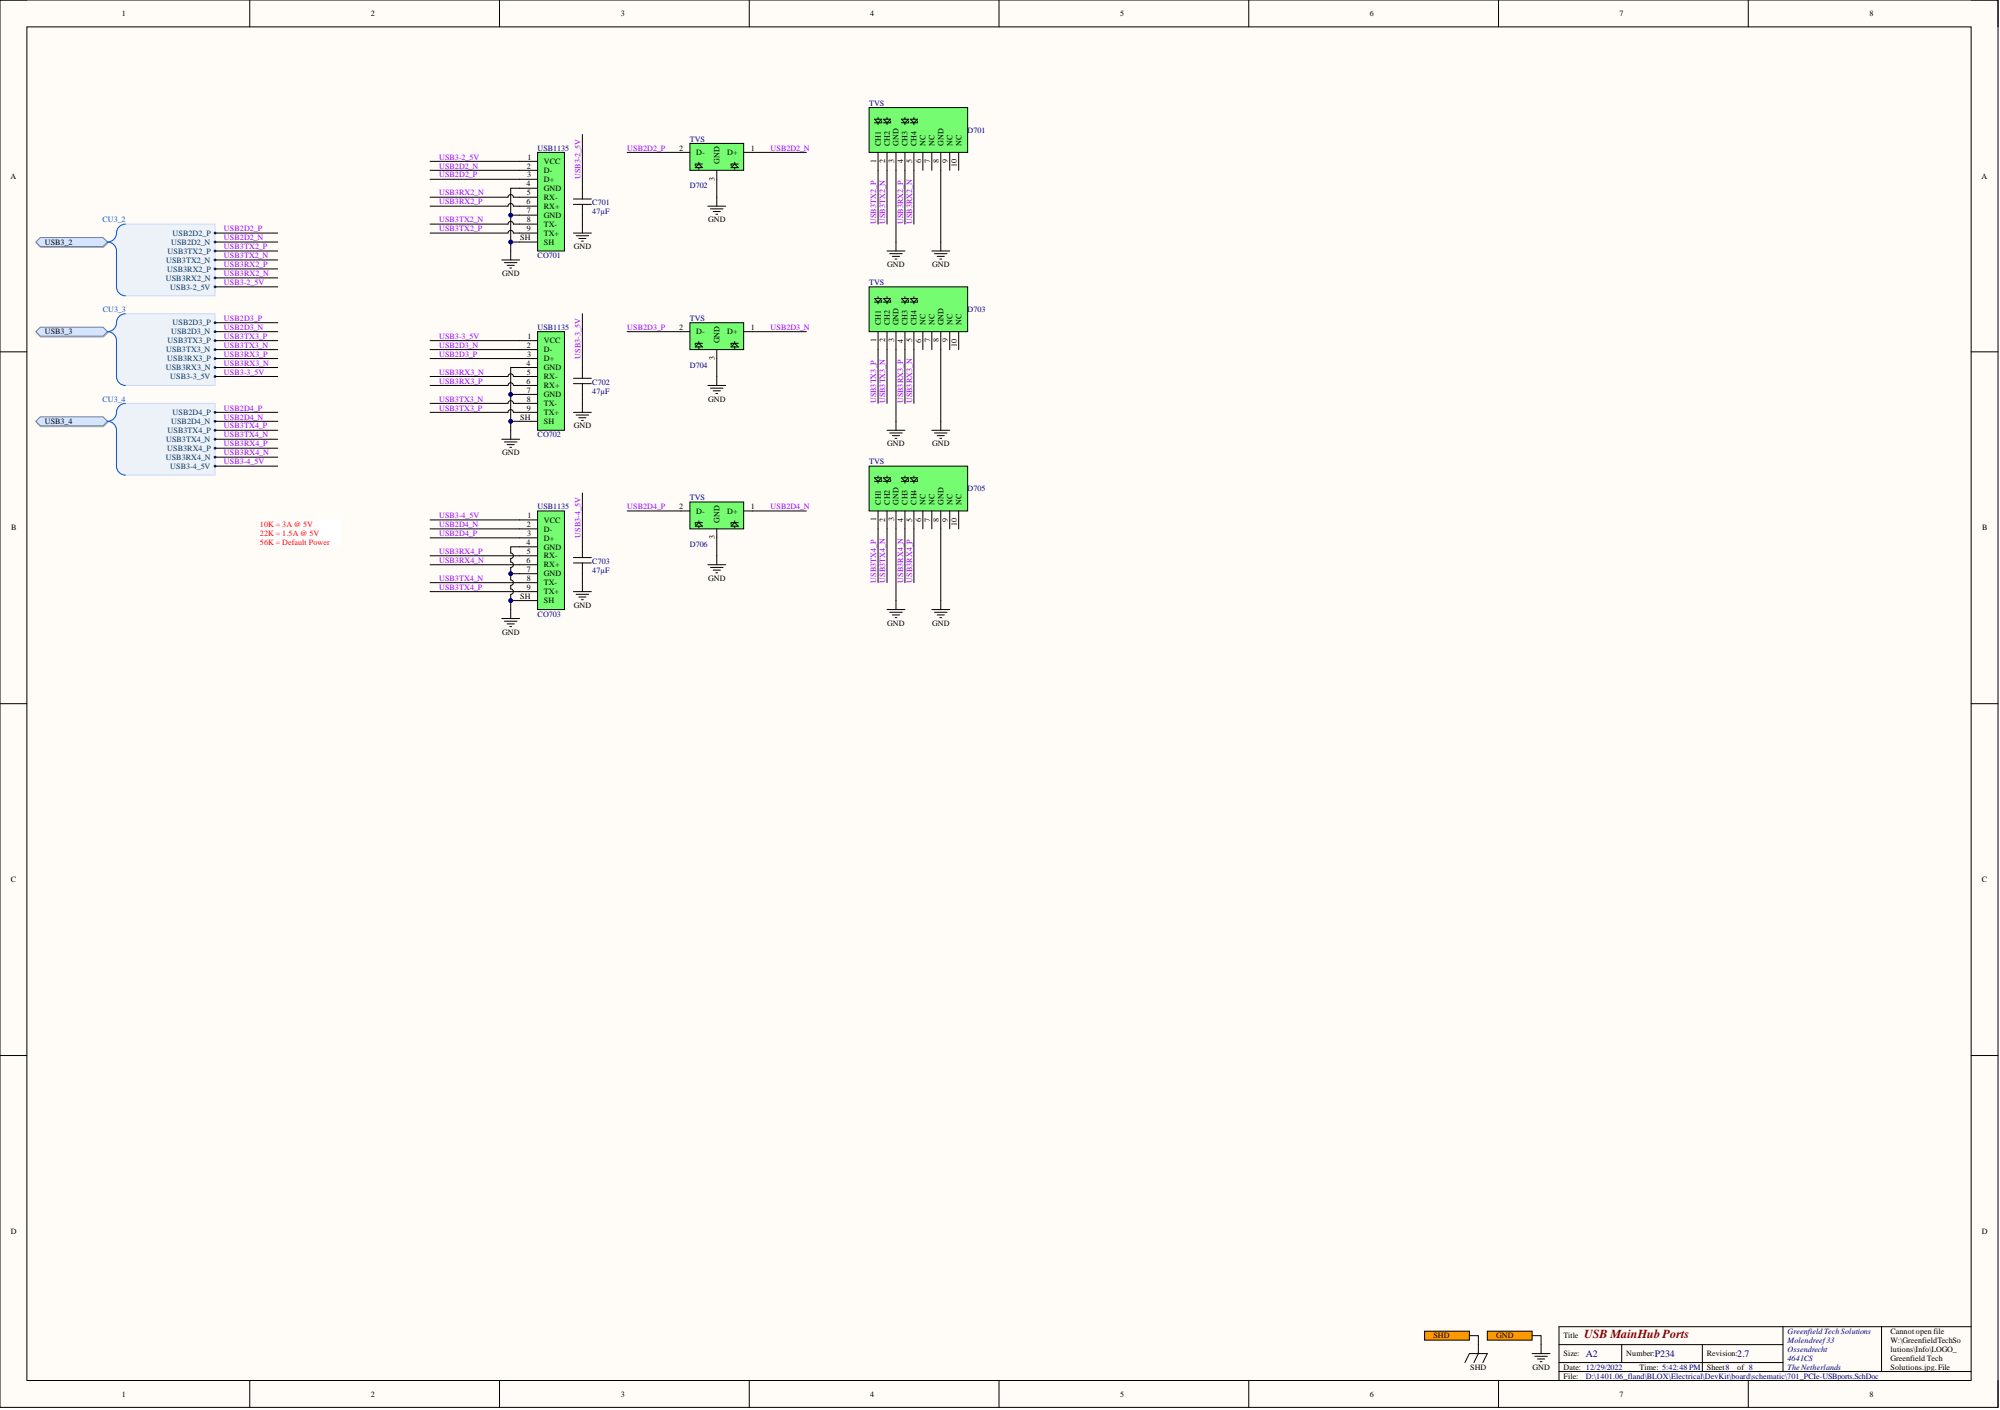
[picture p18: page 8]
