functionland/BLOX/(list of files, drawings)

Other design files:
Electrical/Computer Tower/RPi CM4 Carrier/CM4-Tower.PrjPcb
Electrical/Computer Tower/RPi CM4 Carrier/schematic/01_Top.SchDoc
Electrical/Computer Tower/RPi CM4 Carrier/schematic/02_Power.SchDoc
Electrical/Computer Tower/RPi CM4 Carrier/schematic/03_RPiCM4.SchDoc
Electrical/Computer Tower/RPi CM4 Carrier/schematic/04_PCIe_VL805.SchDoc
Electrical/Computer Tower/RPi CM4 Carrier/schematic/05_HDMI_to_DP.SchDoc
Electrical/Computer Tower/RPi CM4 Carrier/schematic/06_USB_Type-C_DFP.SchDoc
Electrical/Computer Tower/RPi CM4 Carrier/schematic/07_USB_Type-C_DFP_DP_ALT.SchDoc
Electrical/Computer Tower/RPi CM4 Carrier/schematic/08_USB_Type-C_DFP_DP_ALT_buttom.SchDoc
Electrical/Computer Tower/RPi CM4 Carrier/schematic/09_RTC.SchDoc
Electrical/Computer Tower/RPi CM4 Carrier/schematic/10_EEPROM.SchDoc
Electrical/Computer Tower/RPi CM4 Carrier/schematic/11_Revision.SchDoc
Electrical/DevKit/board/BAS_DevKITV3.PrjPcb
Electrical/DevKit/board/schematic/001_OverViewDevKIT.SchDoc
Electrical/DevKit/board/schematic/101_Power.SchDoc
Electrical/DevKit/board/schematic/201_USB3Hub.SchDoc
Electrical/DevKit/board/schematic/301_FrameUSB.SchDoc
Electrical/DevKit/board/schematic/401_RPi0.SchDoc
Electrical/DevKit/board/schematic/501_RPiCM4.SchDoc
Electrical/DevKit/board/schematic/601_PCIe-USB.SchDoc
Electrical/DevKit/board/schematic/701_PCIe-USBports.SchDoc
Electrical/Grid/Back Row/board/001_top.SchDoc
Electrical/Grid/Back Row/board/301_GridPos3.SchDoc
Electrical/Grid/Back Row/board/401_GridPos4.SchDoc
Electrical/Grid/Back Row/board/501_GridPos5.SchDoc
Electrical/Grid/Back Row/board/Back Row.PcbDoc
Electrical/Grid/Back Row/board/Back Row.PrjPcb
Electrical/Grid/Front Row/board/100_top.SchDoc
Electrical/Grid/Front Row/board/101_GridPos1.SchDoc
Electrical/Grid/Front Row/board/201_GridPos2.SchDoc
Electrical/Grid/Front Row/board/301_GridPos3.SchDoc
Electrical/Grid/Front Row/board/401_GridPos4.SchDoc
Electrical/Grid/Front Row/board/501_GridPos5.SchDoc
Electrical/Grid/Front Row/board/601_GridPos6.SchDoc
Electrical/Grid/Front Row/board/701_GridPos7.SchDoc
Electrical/Grid/Front Row/board/801_GridPos8.SchDoc
Electrical/Grid/Front Row/board/Front Row.PrjPcb
Electrical/Grid/Middle Row/board/001_top.SchDoc
Electrical/Grid/Middle Row/board/201_GridPos2.SchDoc
Electrical/Grid/Middle Row/board/301_GridPos3.SchDoc
Electrical/Grid/Middle Row/board/401_GridPos4.SchDoc
Electrical/Grid/Middle Row/board/501_GridPos5.SchDoc
Electrical/Grid/Middle Row/board/601_GridPos6.SchDoc
Electrical/Grid/Middle Row/board/701_GridPos7.SchDoc
Electrical/Grid/Middle Row/board/Middle Row.PrjPcb
Electrical/Hub Tower/AC Carrier/board/001_top.SchDoc
Electrical/Hub Tower/AC Carrier/board/AC Carrier.PcbDoc
Electrical/Hub Tower/AC Carrier/board/AC Carrier.PrjPcb
Electrical/Hub Tower/Button Bridge/board/001_OverViewMainHub-part3.SchDoc
Electrical/Hub Tower/Button Bridge/board/101_Connections.SchDoc
Electrical/Hub Tower/Button Bridge/board/Button Bridge.PcbDoc
Electrical/Hub Tower/Button Bridge/board/Button Bridge.PrjPcb
Electrical/Hub Tower/Double-Width Hub Bridge/board/001_top.SchDoc
Electrical/Hub Tower/Double-Width Hub Bridge/board/101_GridPosMainHub.SchDoc
Electrical/Hub Tower/Double-Width Hub Bridge/board/201_ConnectionPart1-Part2.SchDoc
Electrical/Hub Tower/Double-Width Hub Bridge/board/301_PowerGridUSB.SchDoc
Electrical/Hub Tower/Double-Width Hub Bridge/board/Double-Width Hub Bridge.PrjPcb
Electrical/Hub Tower/SmartHub Carrier/board/001_OverViewMainHub-part2.SchDoc
Electrical/Hub Tower/SmartHub Carrier/board/101_Power.SchDoc
Electrical/Hub Tower/SmartHub Carrier/board/201_ConnectionPart2-Part1.SchDoc
Electrical/Hub Tower/SmartHub Carrier/board/301_FrameUSB.SchDoc
Electrical/Hub Tower/SmartHub Carrier/board/401_FramePWR.schdoc
Electrical/Hub Tower/SmartHub Carrier/board/501_RPi0.SchDoc
Electrical/Hub Tower/SmartHub Carrier/board/601_USBHub-Grid-Part1.SchDoc
Electrical/Hub Tower/SmartHub Carrier/board/701_USBHub-Grid-Part2.SchDoc
Electrical/Hub Tower/SmartHub Carrier/board/801_USBHub-Framework.SchDoc
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
