functionland/BLOX/(commit log)

2022-12-25 -- add Devkit Altium project
    [001_OverViewDevKIT.SchDoc, 101_Power.SchDoc, 201_USB3Hub.SchDoc, 301_FrameUSB.SchDoc, 401_RPi0.SchDoc, 501_RPiCM4.SchDoc, 601_PCIe-USB.SchDoc, 701_PCIe-USBports.SchDoc]
2022-12-29 -- add V3.0 documents and production files
    [101_Power.SchDoc, BAS_DevKITV3.PrjPcb, Bill of Materials-BAS_DevKITV3(Production).xlsx]
2023-01-07 update RADME.md, add Power Adapter section add USB_PD_STUSB5400.md file
2023-01-07 add Flash Raspberry Pi OS to CM4 section to readme.md
2023-01-11 add Flashing VL805 SPI FLASH section
2023-01-11 add Flashing VL805 SPI FLASH
2023-01-11 update Flashing VL805 SPI FLASH
2023-01-17 add USB-C_Horizontal_Bridge altium project
    [USB-C_Horizontal_Bridge.PcbDoc, USB-C_Horizontal_Bridge.PrjPcb, top.SchDoc]
2023-01-17 add Standalone Single-Width Base
    [Standalone Single-Width Base.PcbDoc, Standalone Single-Width Base.PrjPcb, top.SchDoc]
2023-01-17 add grid altium projects
    [001_top.SchDoc, 100_top.SchDoc, 101_GridPos1.SchDoc, 201_GridPos2.SchDoc, 301_GridPos3.SchDoc, 401_GridPos4.SchDoc, 501_GridPos5.SchDoc, 601_GridPos6.SchDoc]
2023-01-17 add Hub Tower altium projects
    [001_OverViewMainHub-part2.SchDoc, 001_OverViewMainHub-part3.SchDoc, 001_top.SchDoc, 101_Connections.SchDoc, 101_GridPosMainHub.SchDoc, 101_Power.SchDoc, 201_ConnectionPart1-Part2.SchDoc, 201_ConnectionPart2-Part1.SchDoc]
2023-01-17 generate production file of "Standalone Single-Width Base" project
    [Standalone Single-Width Base.PcbDoc, Standalone Single-Width Base.PrjPcb, top.SchDoc]
2023-01-17 generate production file of "Single-Width Tower Commons" project
    [USB-C_Horizontal_Bridge.PcbDoc, USB-C_Horizontal_Bridge.PrjPcb, top.SchDoc]
2023-02-04 update USB-C Horizontal Bridge PCB file
    [USB-C_Horizontal_Bridge.PcbDoc]
2023-04-14 -- add RPi CM4 altium project
    [01_Top.SchDoc, 02_Power.SchDoc, 03_RPiCM4.SchDoc, 04_PCIe_VL805.SchDoc, 05_HDMI_to_DP.SchDoc, 06_USB_Type-C_DFP.SchDoc, 07_USB_Type-C_DFP_DP_ALT.SchDoc, 08_USB_Type-C_DFP_DP_ALT_buttom.SchDoc]
2023-05-16 -- update PCB files
    [Standalone Single-Width Base.PcbDoc, Standalone Single-Width Base.PrjPcb, USB-C_Horizontal_Bridge.PcbDoc, USB-C_Horizontal_Bridge.PrjPcb]
